CureaMarioCosmin/Virtual-Instrument-Cluster-for-Electric-Vehicles/Docs/Final Hardware Assembly.jpg

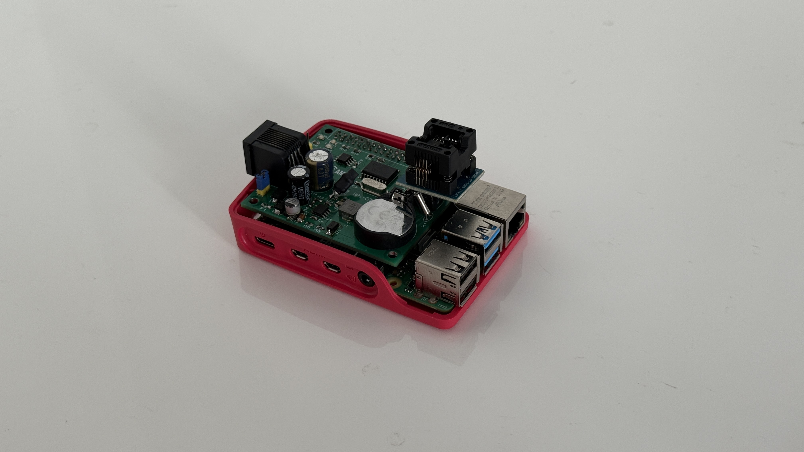
Docs/Final Hardware Assembly.jpg
