CureaMarioCosmin/Virtual-Instrument-Cluster-for-Electric-Vehicles/Docs/Shield Mounted on RaspberryPi.jpg

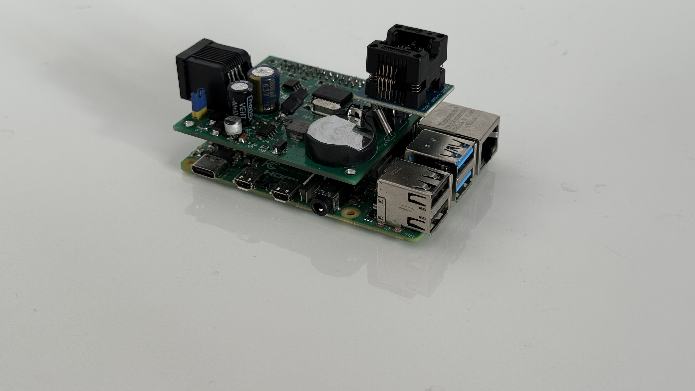
Docs/Shield Mounted on RaspberryPi.jpg
