CureaMarioCosmin/Virtual-Instrument-Cluster-for-Electric-Vehicles/Docs/Project Presentation-Virtual Instrument Cluster for Electric Vehicles.pdf

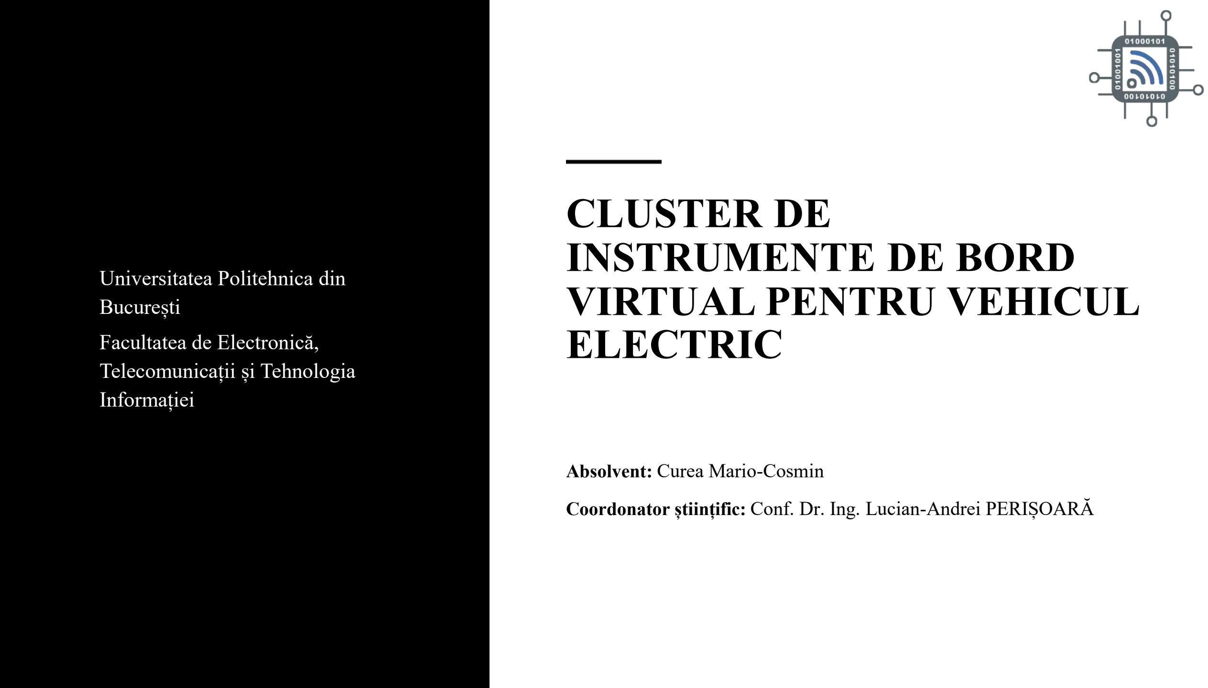
[picture p3: page 1]

## Universitatea Politehnica din București

Facultatea de Electronică,

## Telecomunicații și Tehnologia Informației

# CLUSTER DE INSTRUMENTE DE BORD VIRTUAL PENTRU VEHICUL ELECTRIC

## Absolvent: Curea Mario-Cosmin

## Coordonator științific: Conf. Dr. Ing. Lucian-Andrei PERIȘOARĂ

# Cuprins

### 01 Introducere

### 06 Convertor DC-DC

### 02 Obiective

### 07 Circuit de interfațare cu magistrala CAN

### 03 Arhitectura hardware a sistemului

### 08 Arhitectura Software Python & PyQt5

### 04 Schema electrică a sistemului

### 09 Interfața Grafică

### 05 Proiectare și realizare cablaj imprimat

### 10 Rezultate

### 11 Contribuții

### 12 Direcții viitoare

# Diagrama Gantt a proiectului

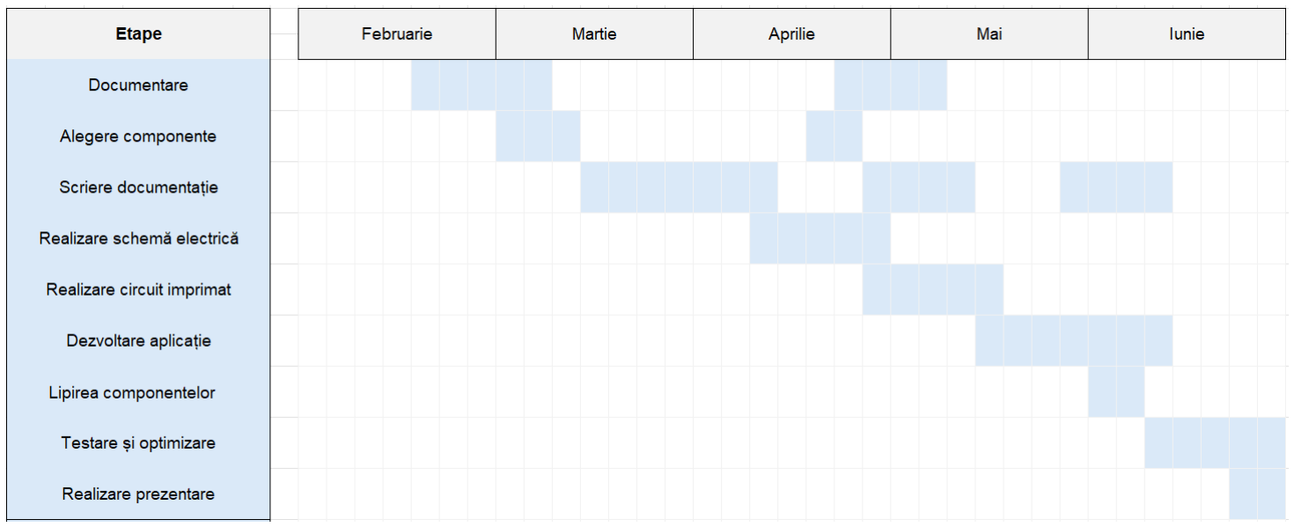
[picture p4: figure]

# Autovehicule electrice

Tranziția industriei auto către autovehicule cu impact ecologic

redus și eficiență superioară a consumului se bazează pe

dezvoltarea vehiculelor electrice

Vehicule electrice cu baterie Vehicule electrice hibrid

Vehicul electric hibrid reîncărcabil Vehicul electric cu autonomie extinsă

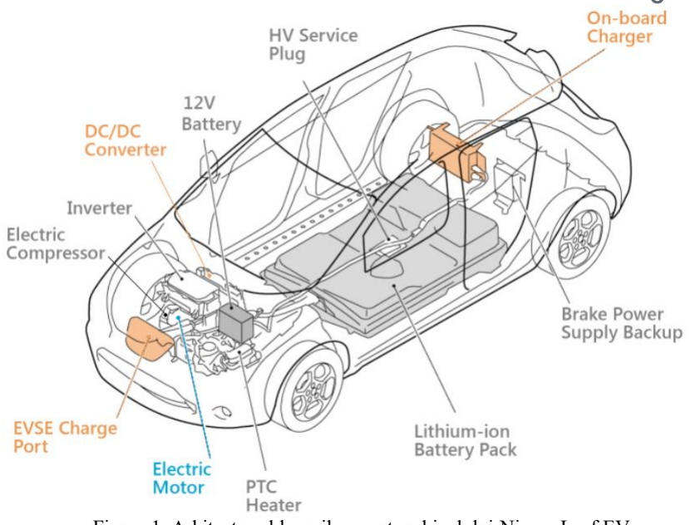
[picture p5: figure]

Figura 1. Arhitectura blocurilor a autovehiculului Nissan Leaf EV

# Magistrala CAN

Protocol de comunicație serială asincronă, robust și

standardizat, dezvoltat special pentru a raspunde cerințelor de

timp real și fiabilitate din industria auto.

Facilitează schimbul rapid, securizat și determinist de date între unitățile de control

Performanță și scalabilitate

Optimizarea resurselor fizice

Toleranță la defectări

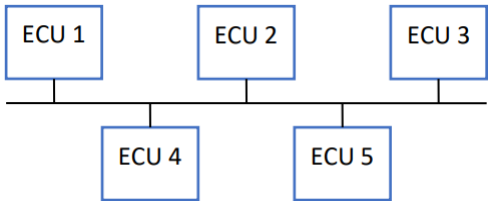
[picture p6: figure]

Figura 2. Comunicație prin magistrală de date serială

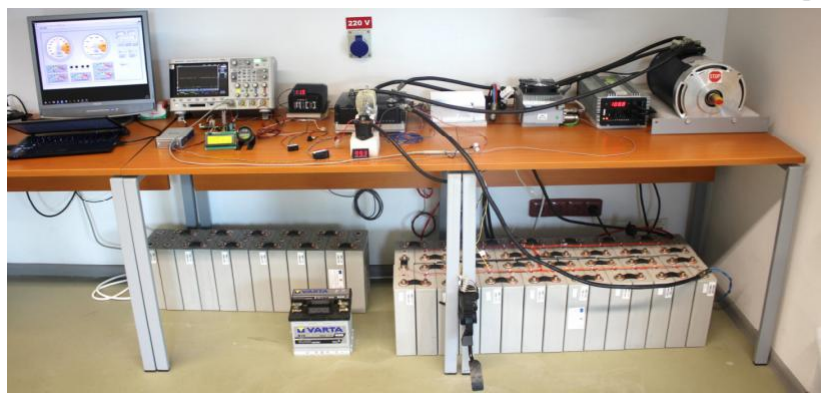
[picture p7: figure]

# Obiective

Dezvoltarea și implementarea unui instrumentar de bord digital

dedicat platformei de testare

Afișarea datelor de la unitățile de control pe un singur ecran

Monitorizarea locală a parametrilor în timp real

Parametrii funcționali: viteză motor electric / curent / tensiune

Parametrii auxiliari: temperaturi motor, baterie, controler, stare

încărcare

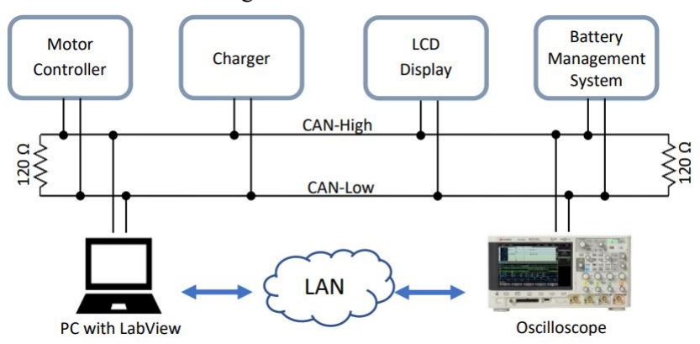
[picture p8: figure]

Figura 4. Rețeaua CAN a platformei de testare

Figura 3. Platforma de testare

Arhitectura hardware a sistemului | Fluxul de date: Platformă VE → Circuit interfațare (TJA1050/MCP2515)
| → Raspberry Pi → Afișaj LCD 7"

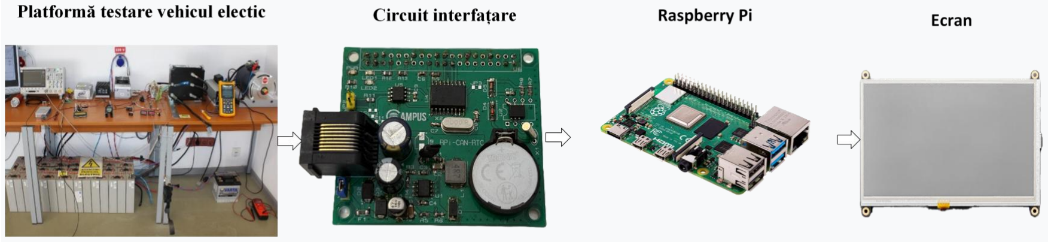
[picture p9: figure]

Figura 5. Schema bloc a arhitecturii hardware și interconexiunile magistralei CAN

# Schema electrică a sistemului

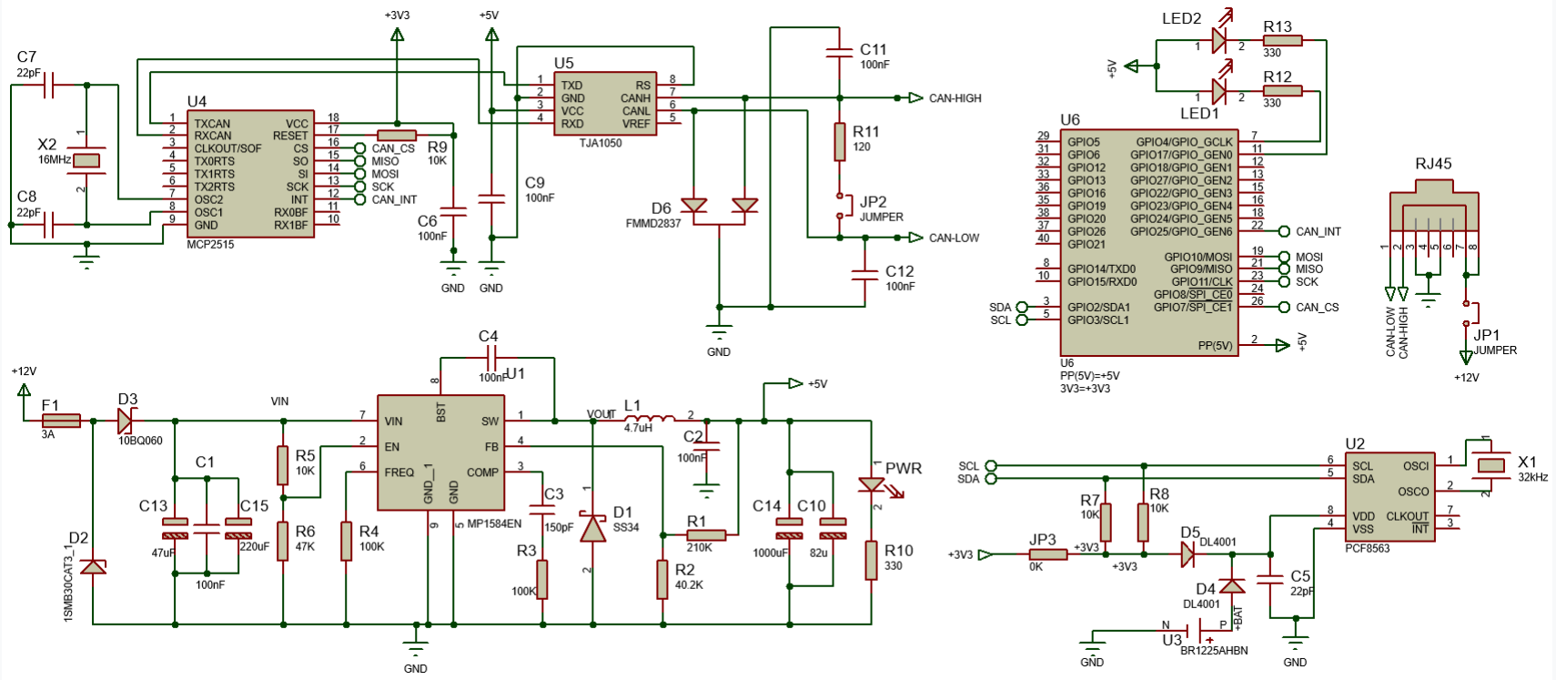
[picture p10: figure]

Figura 6. Schema electrică a proiectului

# Proiectare și realizare cablaj imprimat

Material: Suport FR-4
Dimensiuni: 65 mm × 56 mm

Design: Trasee optimizate și plan de masă pentru disipare termică.

Siguranță: Protecții integrate (diode supratensiune și siguranță fuzibilă).

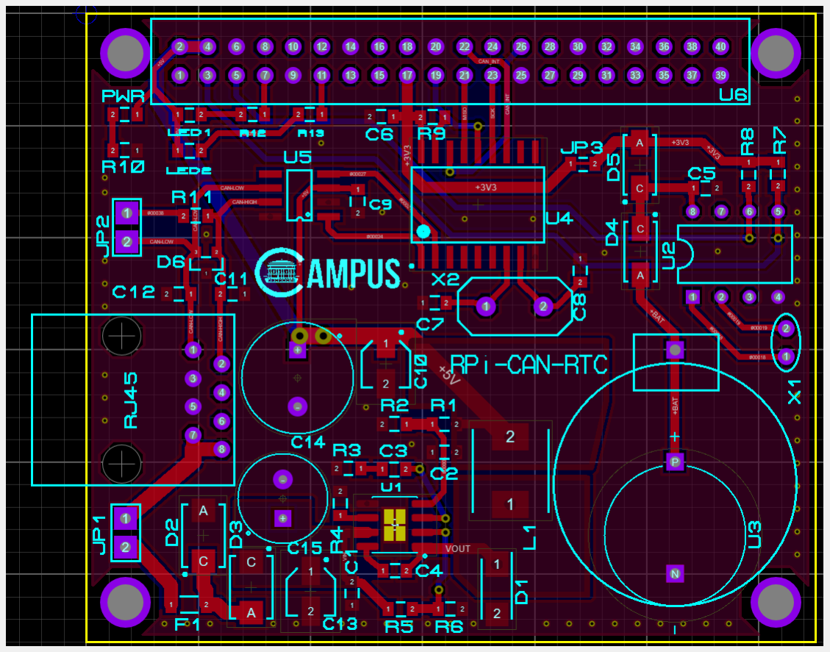
[picture p11: figure]

Figura 7. Designul cablajului imprimat

# Convertor DC-DC

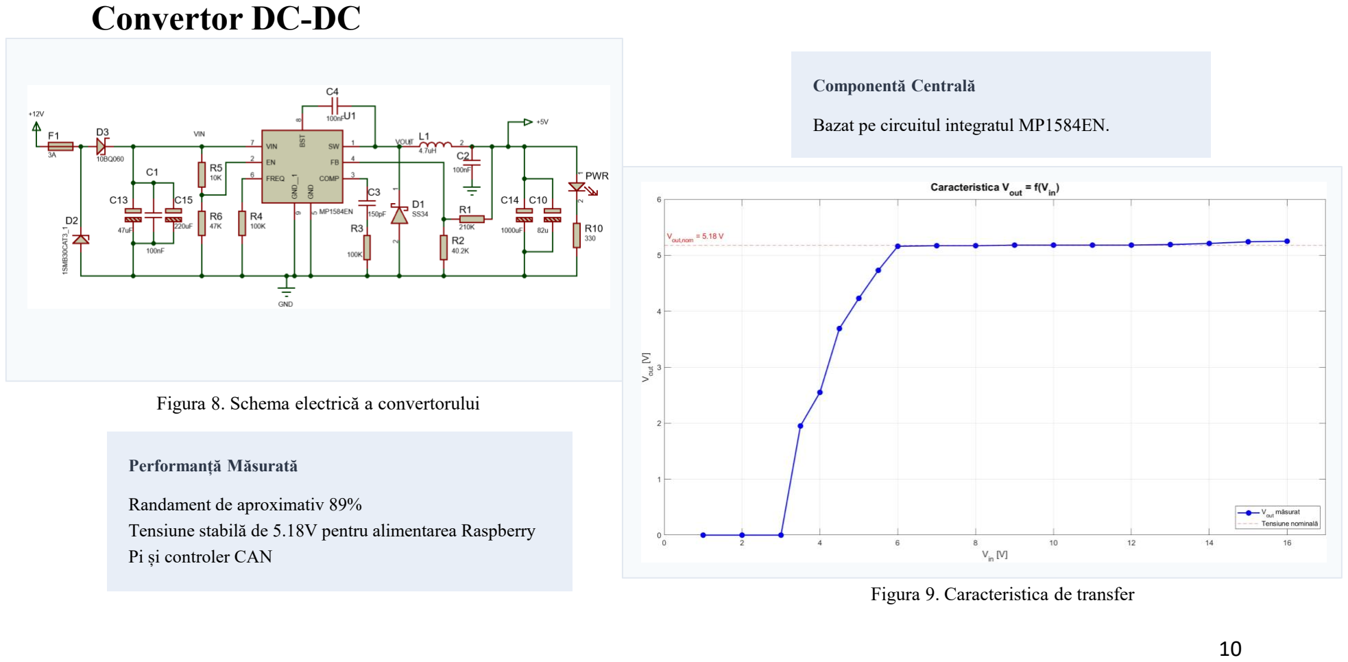
[picture p12: page 10]

Componentă Centrală

Bazat pe circuitul integratul MP1584EN.

Performanță Măsurată

Randament de aproximativ 89%
Tensiune stabilă de 5.18V pentru alimentarea Raspberry Pi și controler CAN

Figura 8. Schema electrică a convertorului

Figura 9. Caracteristica de transfer

# Convertor DC-DC

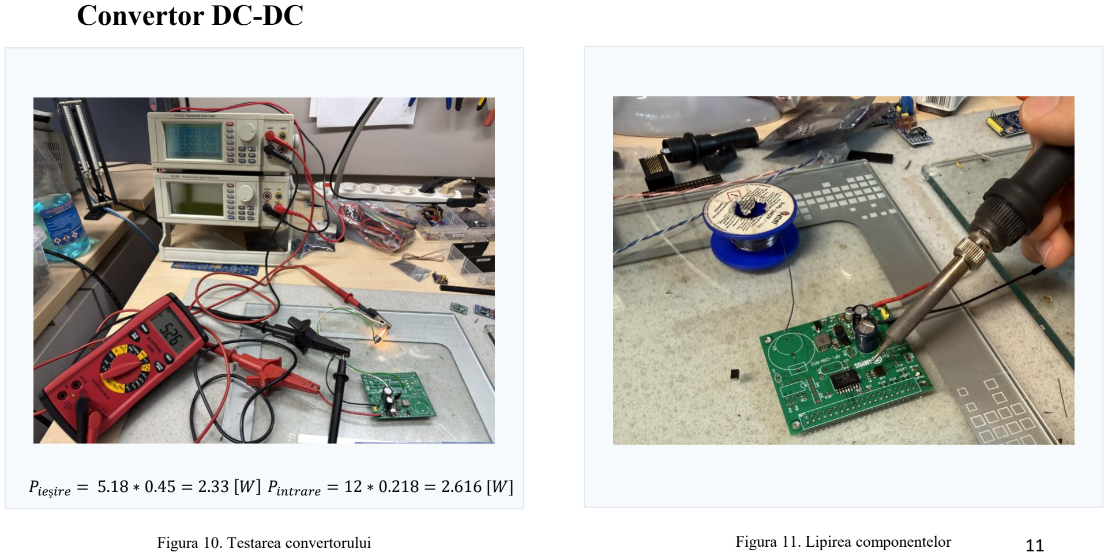
[picture p13: page 11]

Figura 10. Testarea convertorului | Figura 11. Lipirea componentelor
Pieșire = 5.18 ∗ 0.45 = 2.33 | W | Pintrare = 12 ∗ 0.218 = 2.616 [W]

# Circuit de interfațare cu magistrala CAN

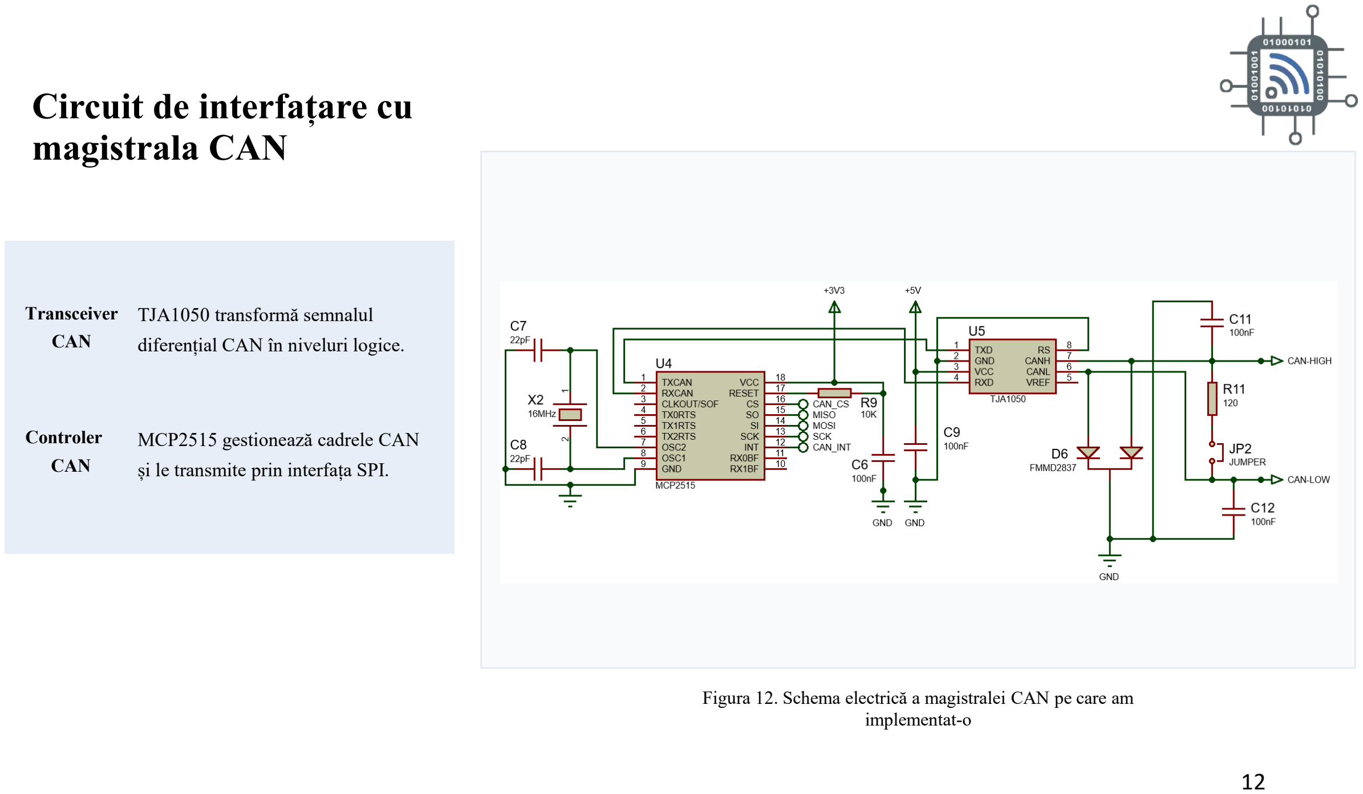
[picture p14: page 12]

Transceiver
CAN

TJA1050 transformă semnalul diferențial CAN în niveluri logice.

Controler
CAN

MCP2515 gestionează cadrele CAN și le transmite prin interfața SPI.

Figura 12. Schema electrică a magistralei CAN pe care am implementat-o

# Arhitectura Software Python & PyQt5

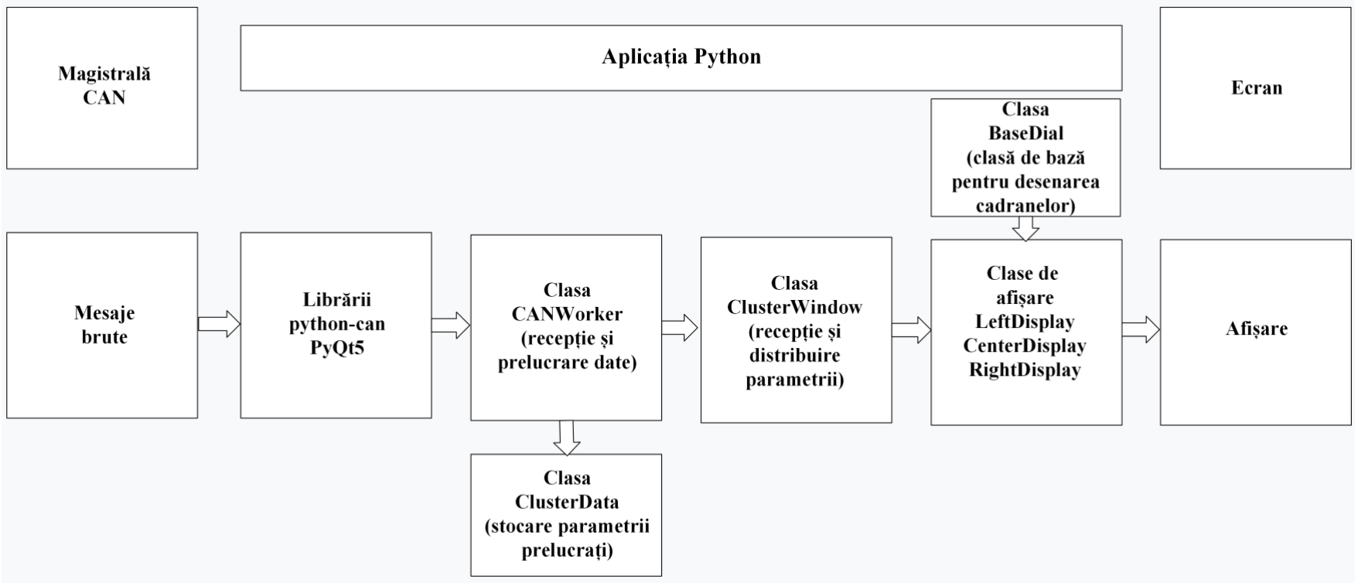
[picture p15: figure]

Figura 13. Arhitectura software și fluxul de procesare a datelor în aplicația Python

# Arhitectura Software Python & PyQt5

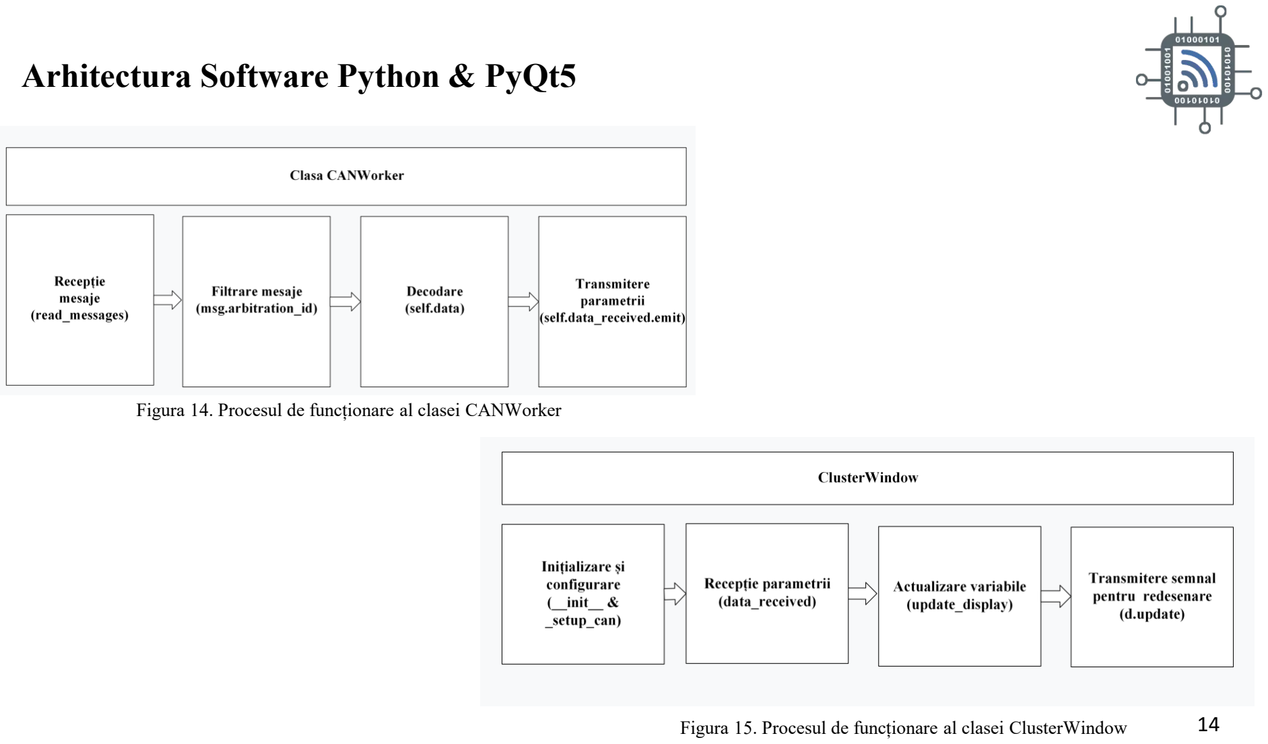
[picture p16: page 14]

Figura 14. Procesul de funcționare al clasei CANWorker

Figura 15. Procesul de funcționare al clasei ClusterWindow | 14

# Interfața Grafică

Indicatoar circular (consum curent) | Viteză motor (rotații pe minut) | Parametri termici și auxiliari

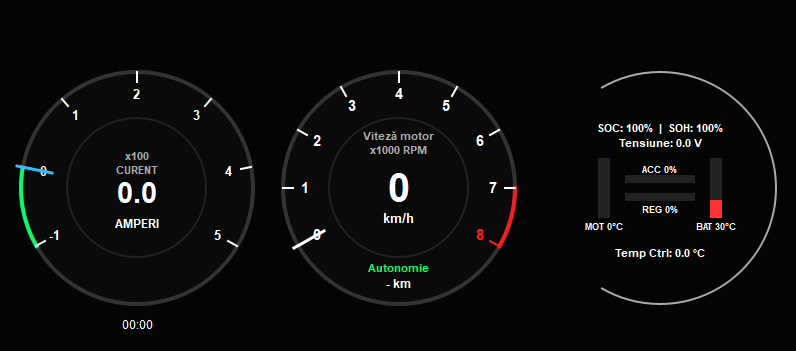
[picture p17: figure]

Figura 16. Interfața grafică finală | 15

# Testare cu ajutorul Arduino

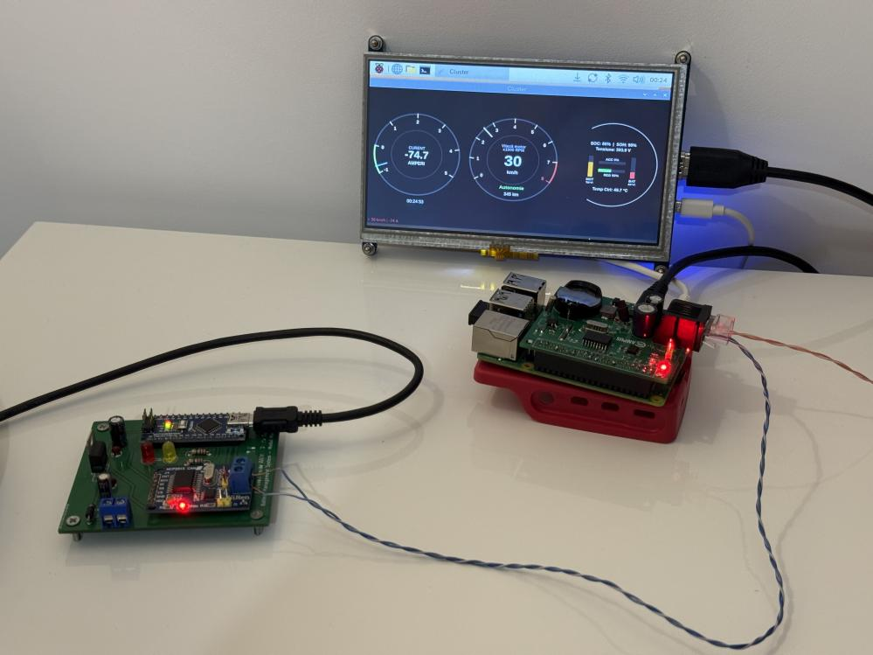
[picture p18: figure]

# Testare pe bancul de lucru

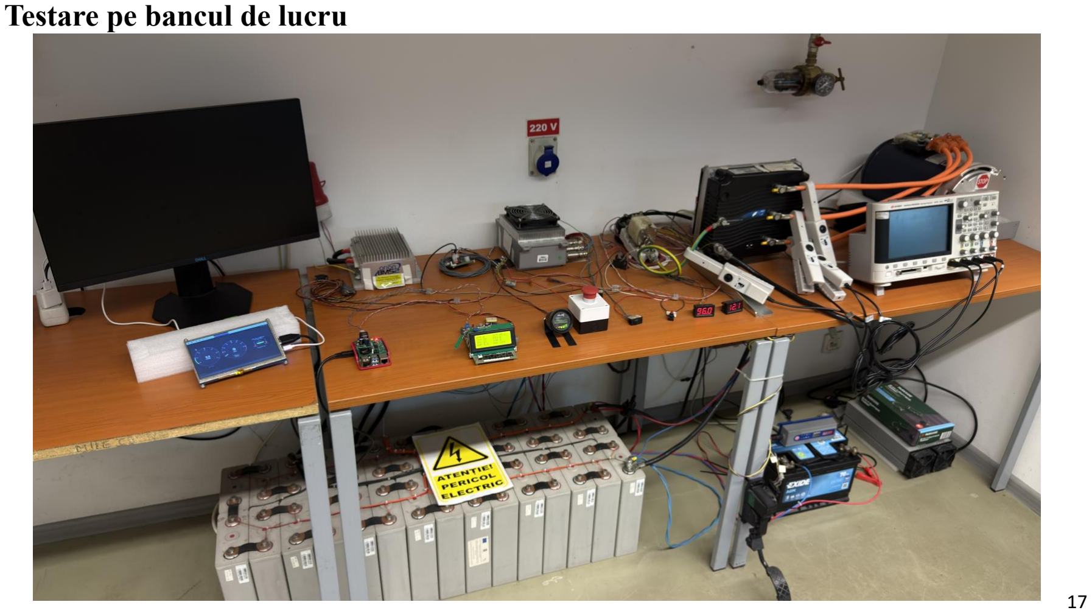
[picture p19: page 17]

# Ce am realizat concret

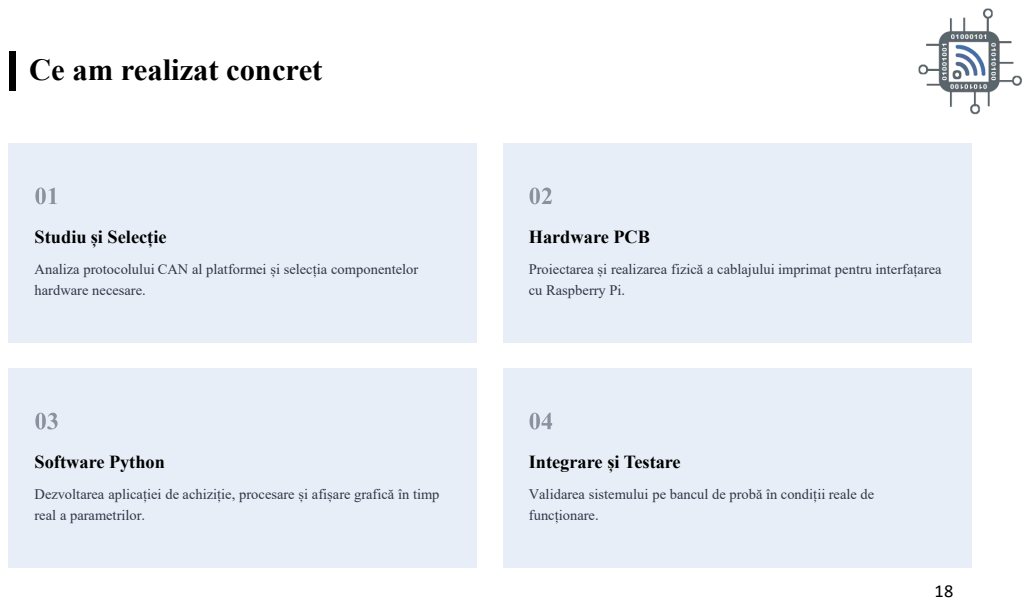
[picture p20: page 18]
Hardware PCB; Software Python

Studiu și Selecție

Analiza protocolului CAN al platformei și selecția componentelor
hardware necesare.

Proiectarea și realizarea fizică a cablajului imprimat pentru interfațarea
cu Raspberry Pi.

Integrare și Testare

Dezvoltarea aplicației de achiziție, procesare și afișare grafică în timp
real a parametrilor.

Validarea sistemului pe bancul de probă în condiții reale de
funcționare.

# DIRECȚII VIITOARE

## Implementarea circuitului într-un autovehicul

Extinderea conectivității prin module wireless (Wi-Fi/Bluetooth).

Implementarea funcției de logging pe card SD.

# Vă mulțumesc pentru atenție!

Implementarea funcțiilor precum remote start sau localizare vehicul.
