CureaMarioCosmin/Virtual-Instrument-Cluster-for-Electric-Vehicles/Hardware/Circuit Diagram.jpg

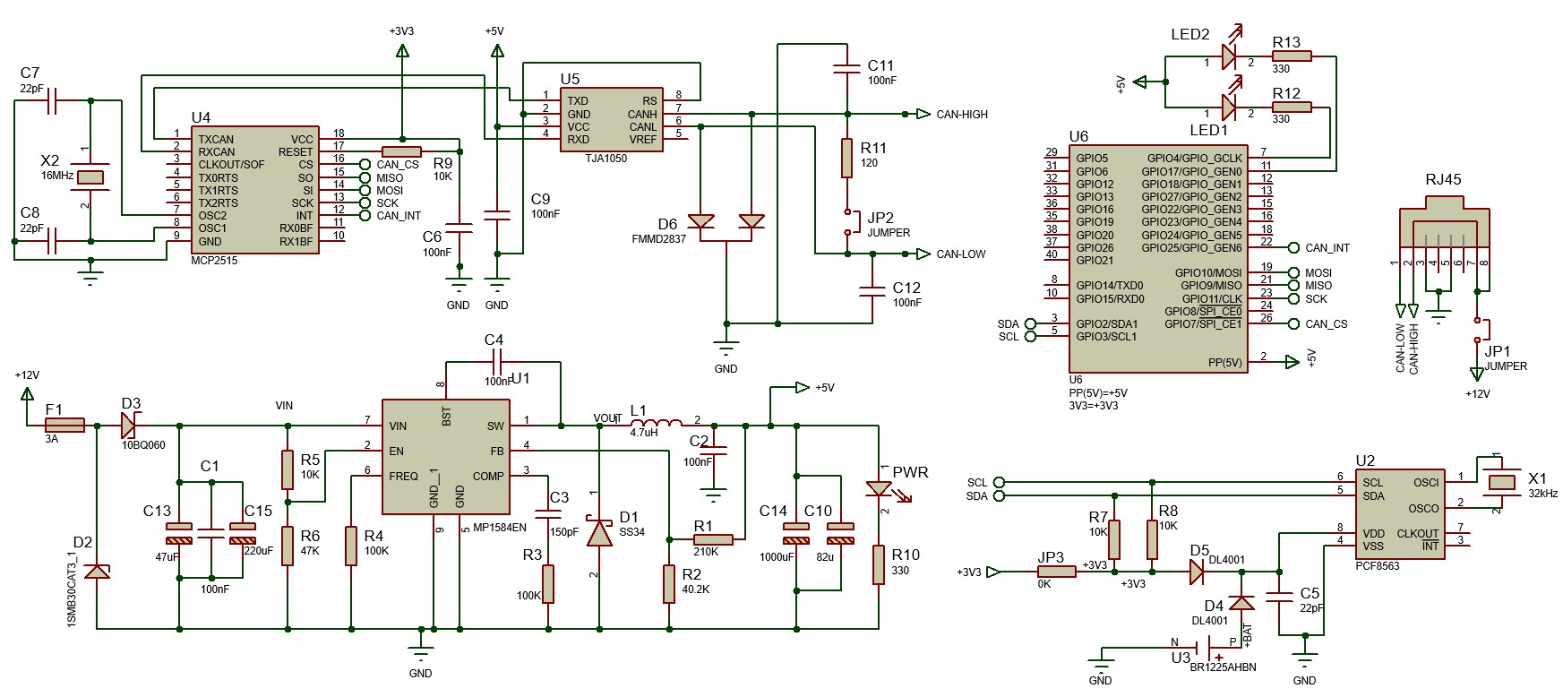
Hardware/Circuit Diagram.jpg
