CureaMarioCosmin/Virtual-Instrument-Cluster-for-Electric-Vehicles/Software/CANWorker diagram.jpg

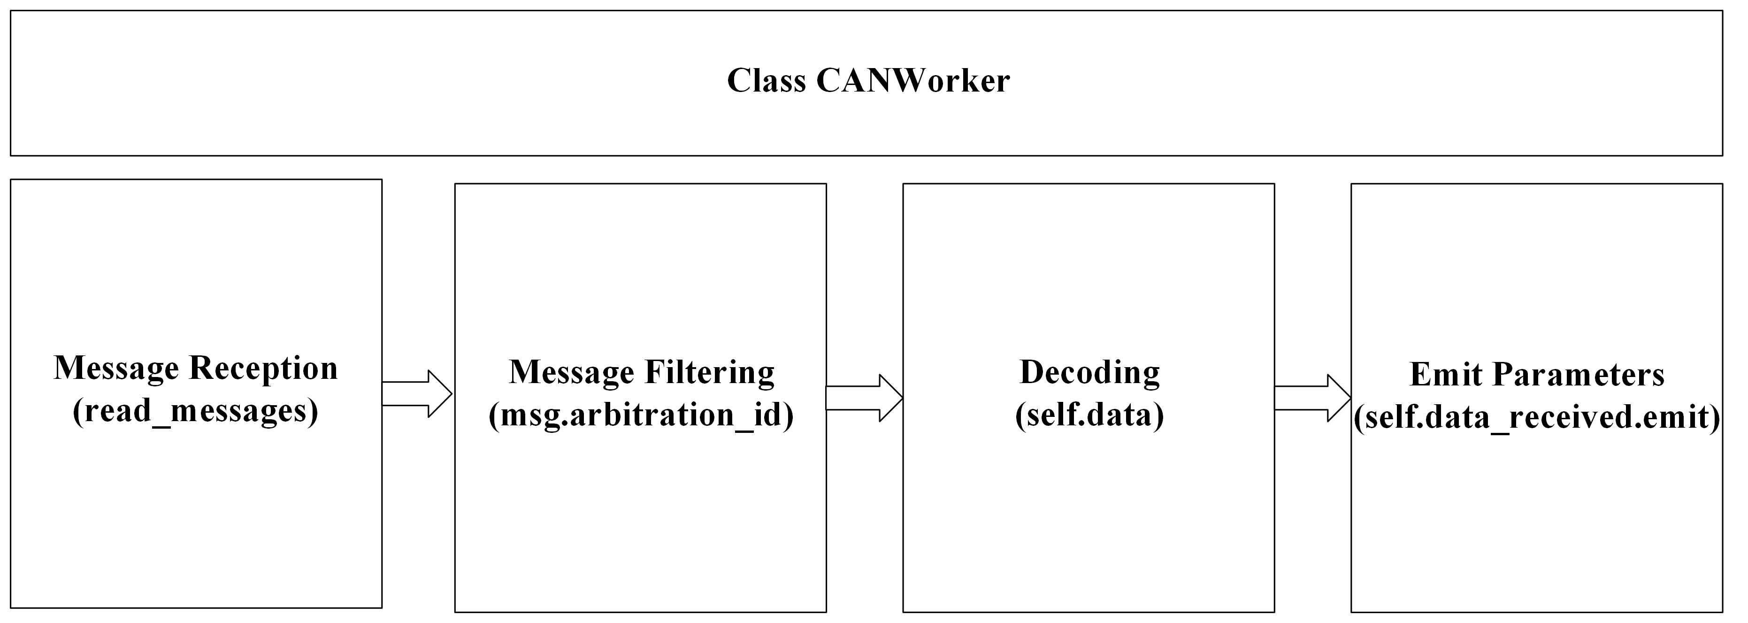
Software/CANWorker diagram.jpg
