CureaMarioCosmin/Virtual-Instrument-Cluster-for-Electric-Vehicles/Software/Functional Block Diagram.jpg

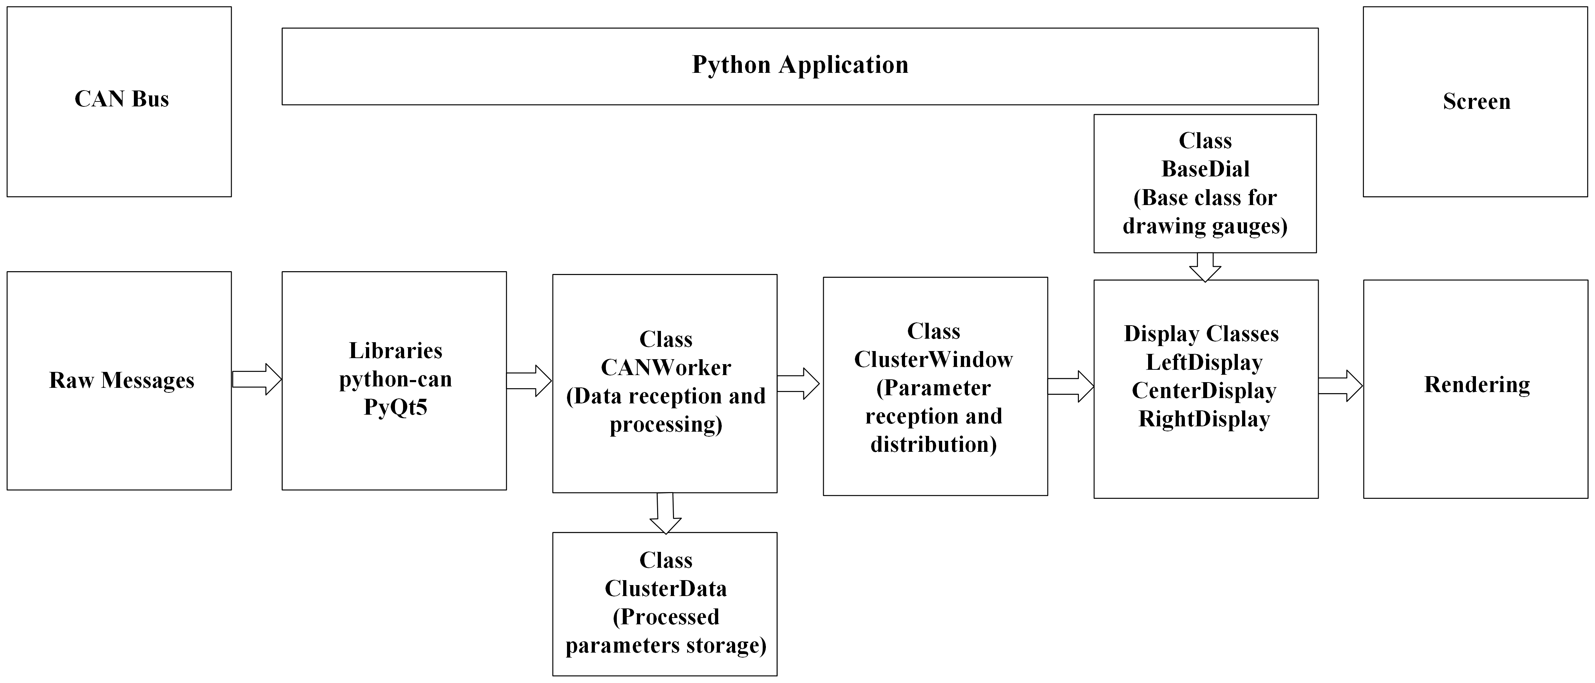
Software/Functional Block Diagram.jpg
