CureaMarioCosmin/Virtual-Instrument-Cluster-for-Electric-Vehicles/Software/Rendering diagram.jpg

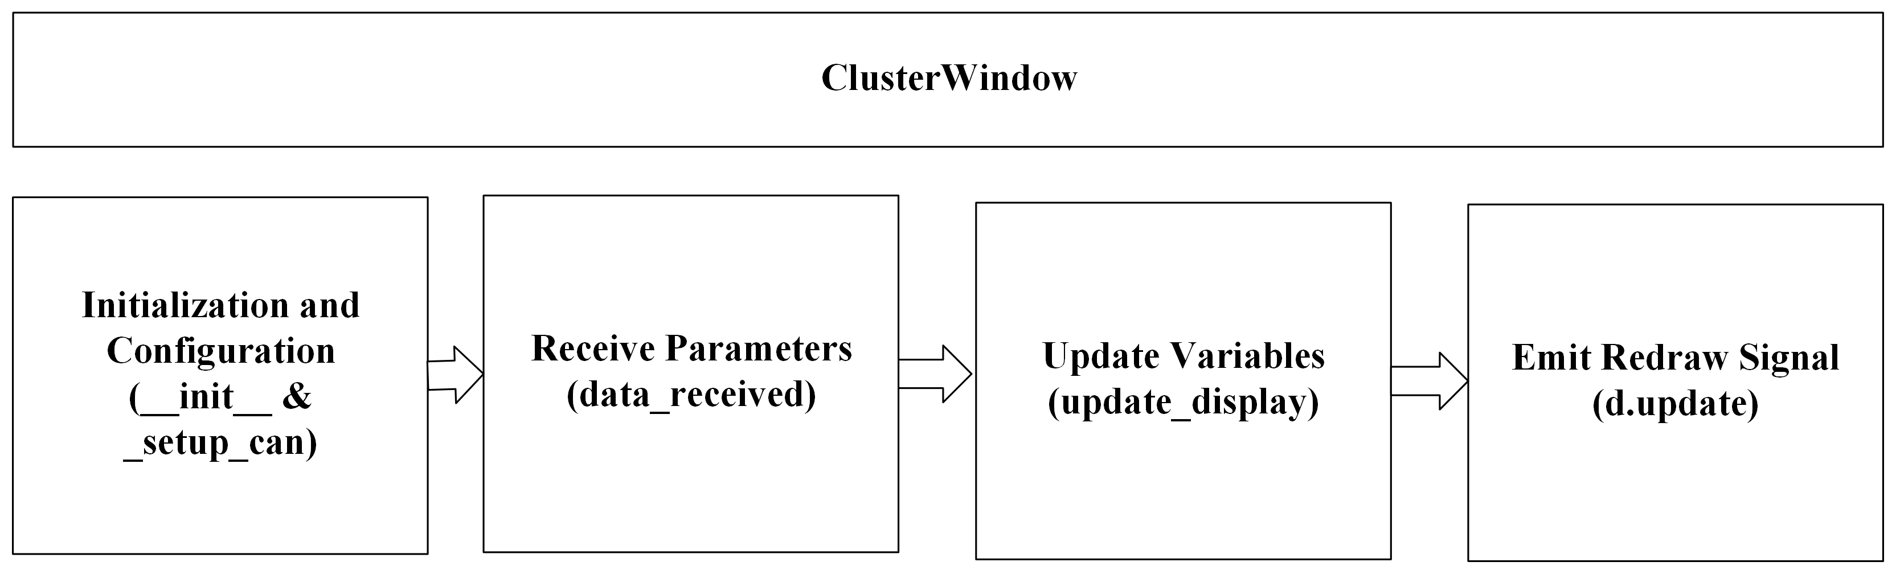
Software/Rendering diagram.jpg
