CureaMarioCosmin/Virtual-Instrument-Cluster-for-Electric-Vehicles/(list of files, drawings)

Other design files:
Hardware/circuit+PCB v6_PROTEUS.pdsprj
