CureaMarioCosmin/Virtual-Instrument-Cluster-for-Electric-Vehicles/Docs/Custom Interface Shield.jpg

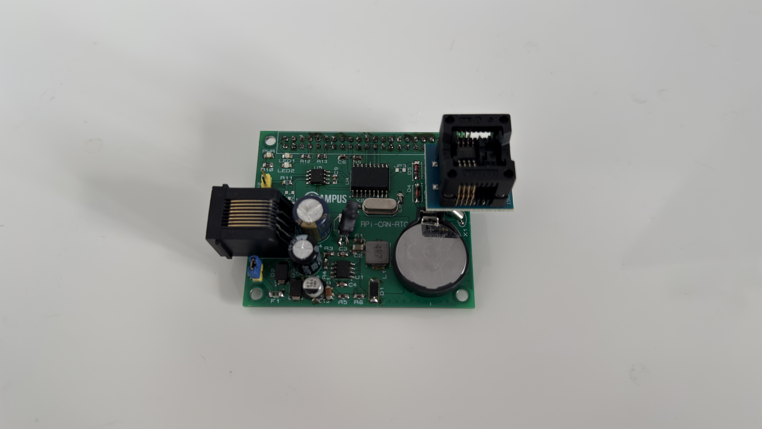
Docs/Custom Interface Shield.jpg
